gabeak2/RP2040_PIO_DAC/README.md

https://www.youtube.com/watch?v=1zT0gdcFlgw
