gabeak2/RP2040_PIO_DAC/pi_pico_dds.kicad_pcb

## KiCad design pi_pico_dds.kicad_pcb (2024-01-13)

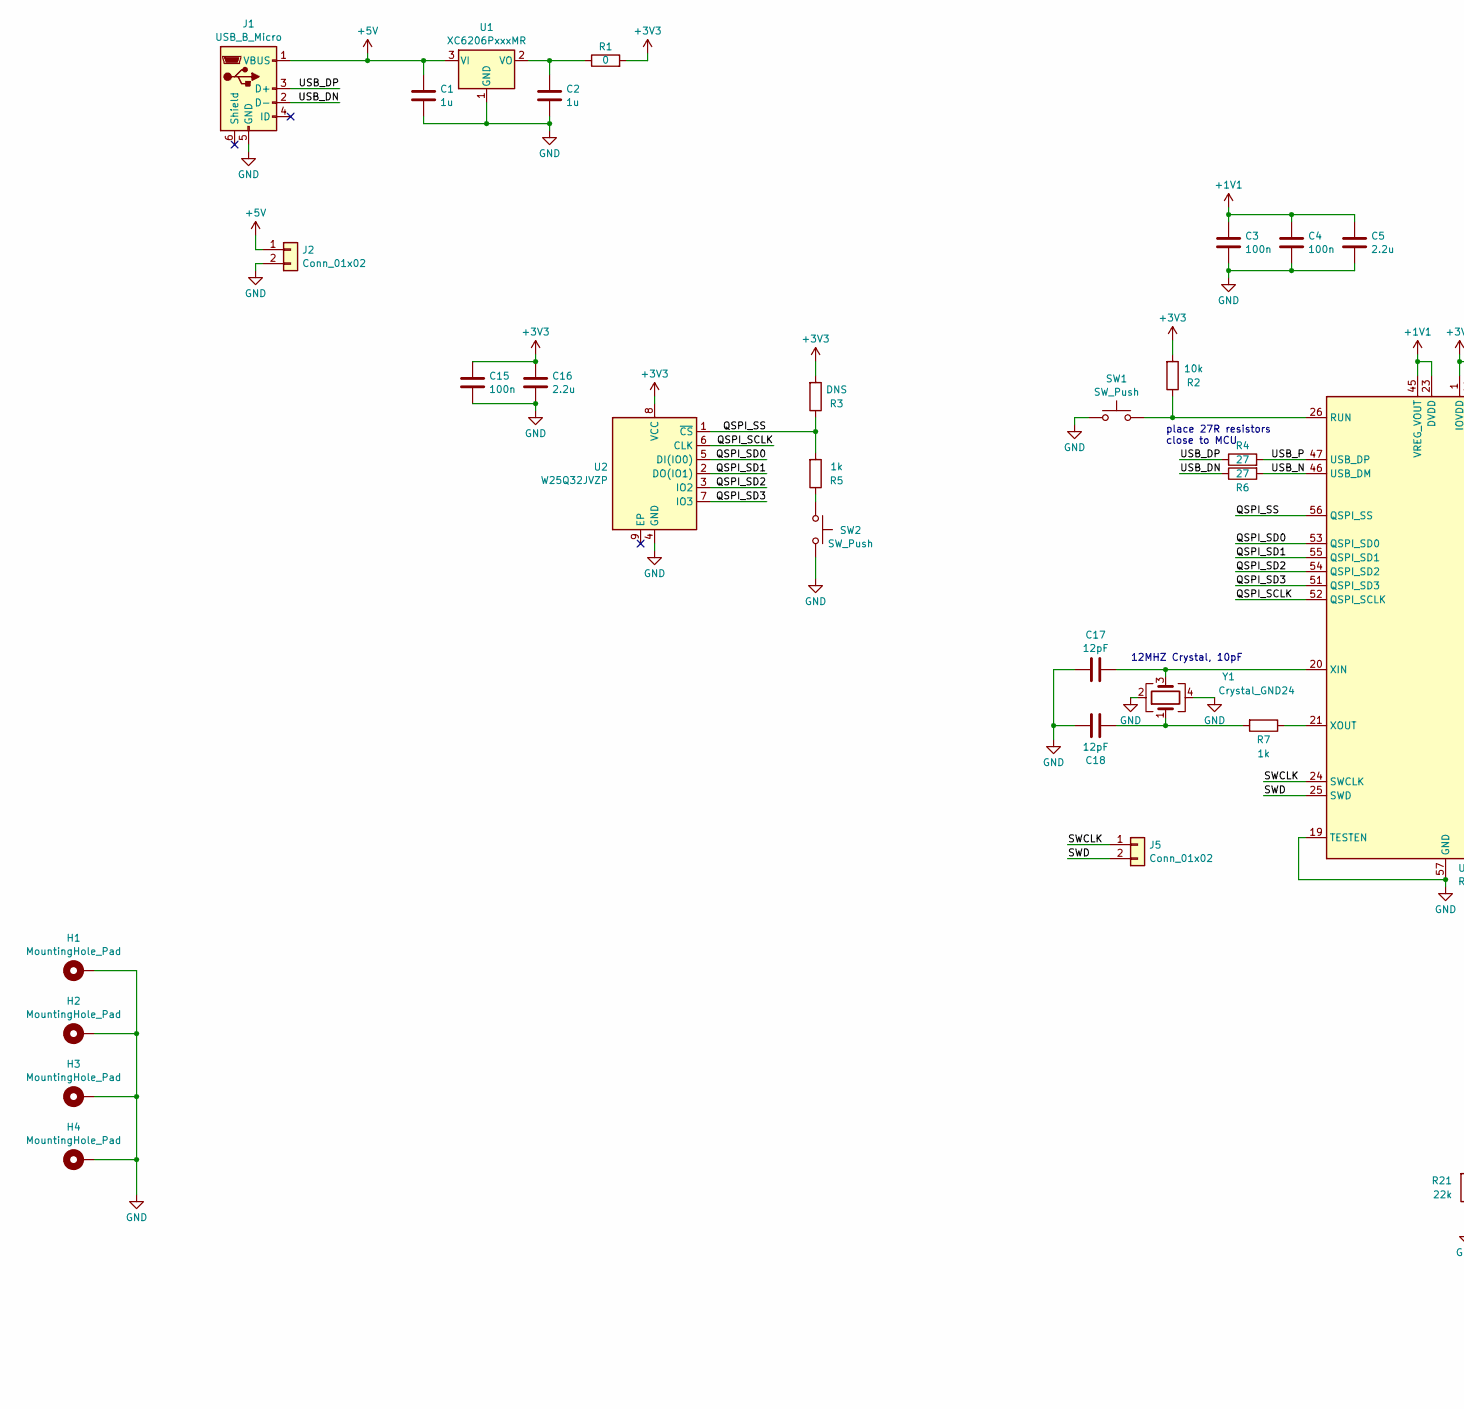
[picture p1: schematic pi_pico_dds.kicad_sch, part in row 1, column 1]

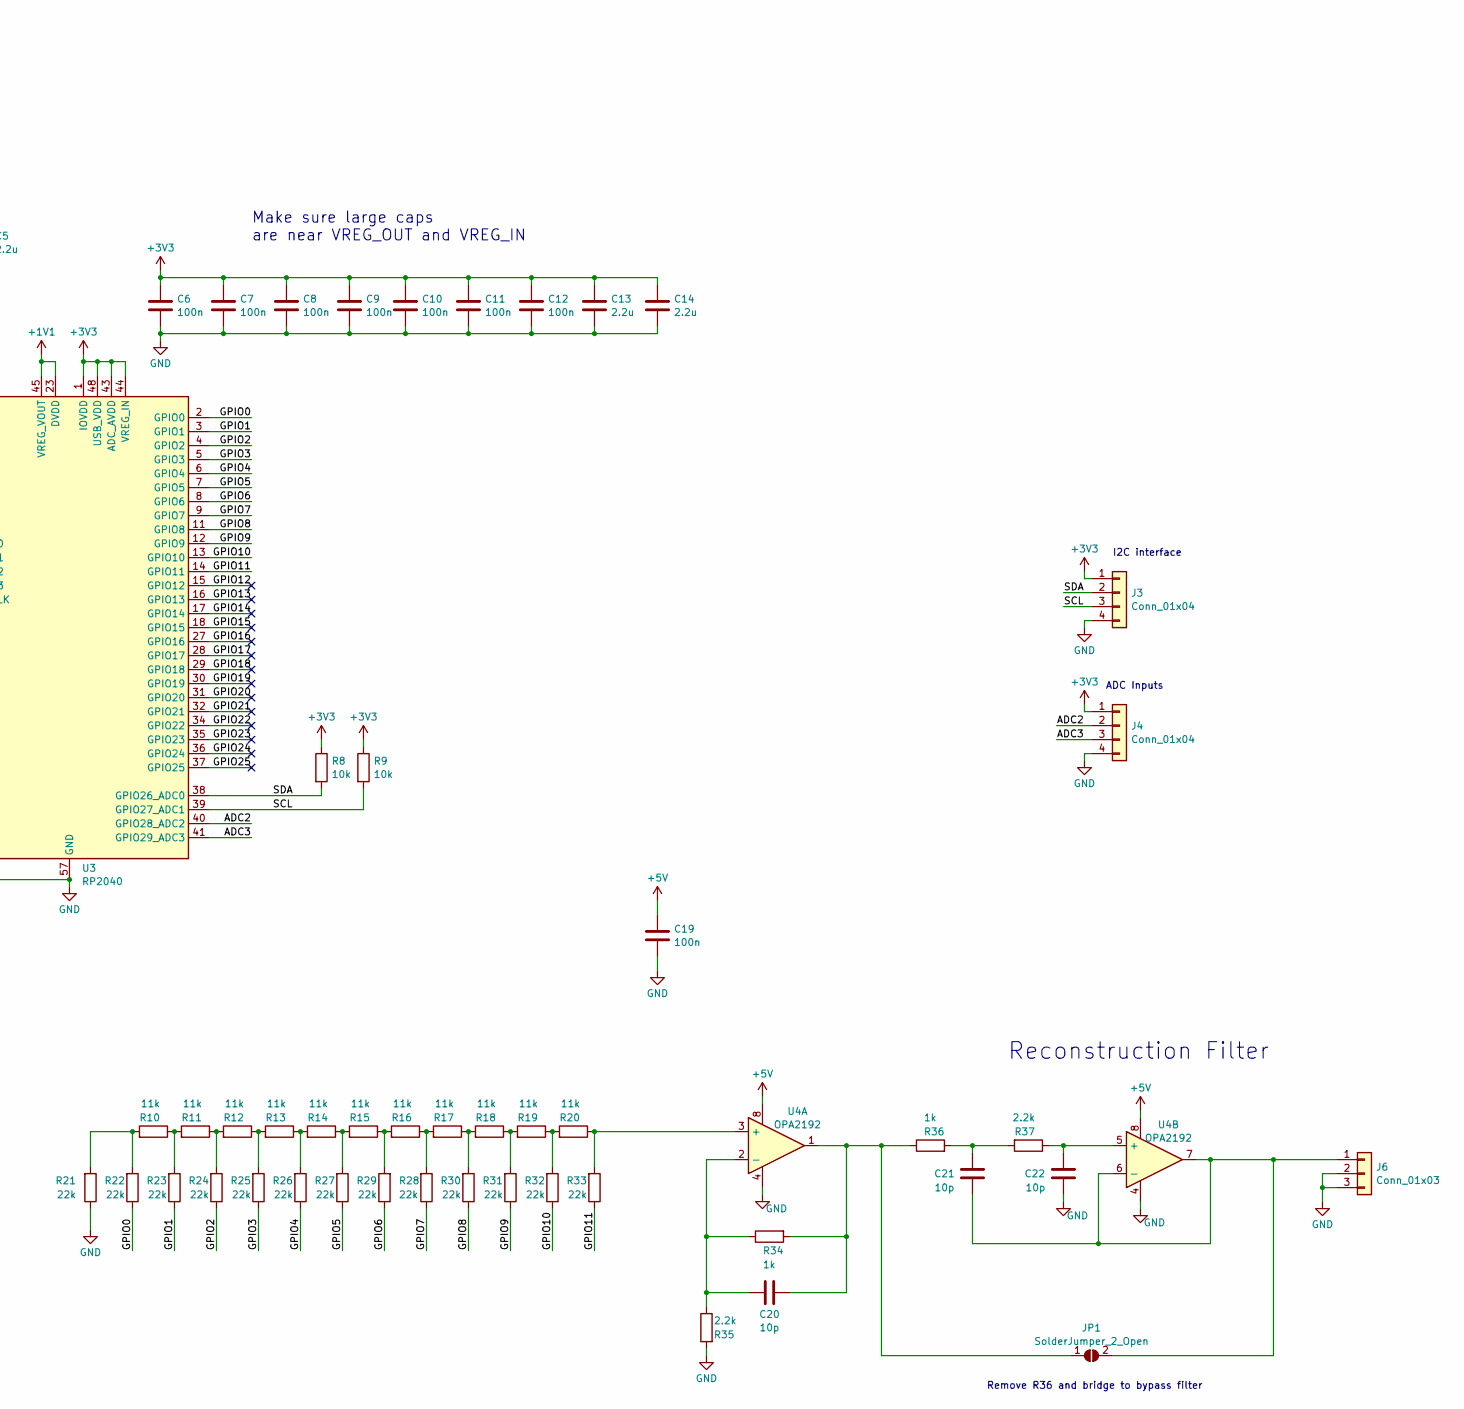
[picture p2: schematic pi_pico_dds.kicad_sch, part in row 1, column 2]

Parts:
C1, C2: 1u; C_0402_1005Metric; LCSC C52923
C3, C4, C6, C7, C8, C9, C10, C11, C12, C15, C19: 100n; C_0402_1005Metric; LCSC C307331
C5, C13, C14, C16: 2.2u; C_0402_1005Metric; LCSC C12530
C17, C18: 12pF; C_0402_1005Metric; LCSC C1547
C20, C21, C22: 10p; C_0402_1005Metric; LCSC C32949
H1, H2, H3, H4: MountingHole_Pad; MountingHole_2.2mm_M2_DIN965_Pad
J1: USB_B_Micro; USB_Micro-B_Molex-105017-0001; LCSC C505111
J2, J5: Conn_01x02; PinSocket_1x02_P2.54mm_Vertical
J3, J4: Conn_01x04; PinSocket_1x04_P2.54mm_Vertical
J6: Conn_01x03; PinSocket_1x03_P2.54mm_Vertical
JP1: SolderJumper_2_Open; SolderJumper-2_P1.3mm_Open_Pad1.0x1.5mm
R1: 0; R_0402_1005Metric; LCSC C17168
R2, R8, R9: 10k; R_0402_1005Metric; LCSC C25744
R3: DNS; R_0402_1005Metric
R4, R6: 27; R_0402_1005Metric; LCSC C25100
R5, R7, R34, R36: 1k; R_0402_1005Metric; LCSC C11702
R10, R11, R12, R13, R14, R15, R16, R17, R18, R19, R20: 11k; R_0402_1005Metric; LCSC C705064
R21, R22, R23, R24, R25, R26, R27, R28, R29, R30, R31, R32, R33: 22k; R_0402_1005Metric; LCSC C326601
R35, R37: 2.2k; R_0402_1005Metric; LCSC C25879
SW1, SW2: SW_Push; SW_Push_1P1T_XKB_TS-1187A
U1: XC6206PxxxMR; SOT-23-3; LCSC C5446
U2: W25Q32JVZP; WSON-8-1EP_6x5mm_P1.27mm_EP3.4x4.3mm; LCSC C571260
U3: RP2040; QFN-56-1EP_7x7mm_P0.4mm_EP3.2x3.2mm; LCSC C2040
U4: OPA2192; SOIC-8_3.9x4.9mm_P1.27mm; LCSC C110074
Y1: Crystal_GND24; Crystal_SMD_3225-4Pin_3.2x2.5mm; LCSC C50430

Connections:
+1V1: C3.1, C4.1, C5.1, U3.23 (DVDD), U3.45 (VREG_VOUT), U3.50 (DVDD)
+3V3: C6.1, C7.1, C8.1, C9.1, C10.1, C11.1, C12.1, C13.1, C14.1, C15.1, C16.1, J3.1, J4.1, R1.2, R2.2, R3.2, R8.1, R9.1, U2.8 (VCC), U3.1 (IOVDD), U3.10 (IOVDD), U3.22 (IOVDD), U3.33 (IOVDD), U3.42 (IOVDD), U3.43 (ADC_AVDD), U3.44 (VREG_IN), U3.48 (USB_VDD), U3.49 (IOVDD)
+5V: C1.1, C19.1, J1.1 (VBUS), J2.1, U1.3 (VI), U4.8
/ADC2: J4.2, U3.40 (GPIO28_ADC2)
/ADC3: J4.3, U3.41 (GPIO29_ADC3)
/GPIO0: R22.1, U3.2 (GPIO0)
/GPIO1: R23.1, U3.3 (GPIO1)
/GPIO2: R24.1, U3.4 (GPIO2)
/GPIO3: R25.1, U3.5 (GPIO3)
/GPIO4: R26.1, U3.6 (GPIO4)
/GPIO5: R27.1, U3.7 (GPIO5)
/GPIO6: R28.1, U3.8 (GPIO6)
/GPIO7: R29.1, U3.9 (GPIO7)
/GPIO8: R30.1, U3.11 (GPIO8)
/GPIO9: R31.1, U3.12 (GPIO9)
/GPIO10: R32.1, U3.13 (GPIO10)
/GPIO11: R33.1, U3.14 (GPIO11)
/GPIO12: U3.15 (GPIO12)
/GPIO13: U3.16 (GPIO13)
/GPIO14: U3.17 (GPIO14)
/GPIO15: U3.18 (GPIO15)
/GPIO16: U3.27 (GPIO16)
/GPIO17: U3.28 (GPIO17)
/GPIO18: U3.29 (GPIO18)
/GPIO19: U3.30 (GPIO19)
/GPIO20: U3.31 (GPIO20)
/GPIO21: U3.32 (GPIO21)
/GPIO22: U3.34 (GPIO22)
/GPIO23: U3.35 (GPIO23)
/GPIO24: U3.36 (GPIO24)
/GPIO25: U3.37 (GPIO25)
/QSPI_SCLK: U2.6 (CLK), U3.52 (QSPI_SCLK)
/QSPI_SD0: U2.5 (DI(IO0)), U3.53 (QSPI_SD0)
/QSPI_SD1: U2.2 (DO(IO1)), U3.55 (QSPI_SD1)
/QSPI_SD2: U2.3 (IO2), U3.54 (QSPI_SD2)
/QSPI_SD3: U2.7 (IO3), U3.51 (QSPI_SD3)
/QSPI_SS: R3.1, R5.2, U2.1 (~CS), U3.56 (QSPI_SS)
/SCL: J3.3, R9.2, U3.39 (GPIO27_ADC1)
/SDA: J3.2, R8.2, U3.38 (GPIO26_ADC0)
/SWCLK: J5.1, U3.24 (SWCLK)
/SWD: J5.2, U3.25 (SWD)
/USB_DN: J1.2 (D-), R6.1
/USB_DP: J1.3 (D+), R4.1
/USB_N: R6.2, U3.46 (USB_DM)
/USB_P: R4.2, U3.47 (USB_DP)
GND: C1.2, C2.2, C3.2, C4.2, C5.2, C6.2, C7.2, C8.2, C9.2, C10.2, C11.2, C12.2, C13.2, C14.2, C15.2, C16.2, C17.1, C18.1, C19.2, C22.2, H1.1, H2.1, H3.1, H4.1, J1.5 (GND), J2.2, J3.4, J4.4, J6.2, J6.3, R21.1, R35.2, SW1.1, SW2.1, U1.1 (GND), U2.4 (GND), U3.19 (TESTEN), U3.57 (GND), U4.4, Y1.2, Y1.4
unnamed: C18.2, R7.2, Y1.1
unnamed: C21.1, R36.2, R37.2
unnamed: C21.2, J6.1, JP1.2 (B), U4.6 (-), U4.7
unnamed: C20.1, JP1.1 (A), R34.2, R36.1, U4.1
unnamed: R5.1, SW2.2
unnamed: R10.1, R11.2, R23.2
unnamed: R10.2, R21.2, R22.2
unnamed: R11.1, R12.2, R24.2
unnamed: R12.1, R13.2, R25.2
unnamed: R13.1, R14.2, R26.2
unnamed: R14.1, R15.2, R27.2
unnamed: R15.1, R16.2, R28.2
unnamed: R16.1, R17.2, R29.2
unnamed: R17.1, R18.2, R30.2
unnamed: R18.1, R19.2, R31.2
unnamed: R19.1, R20.2, R32.2
unnamed: C2.1, R1.1, U1.2 (VO)
unnamed: R2.1, SW1.2, U3.26 (RUN)
unnamed: C17.2, U3.20 (XIN), Y1.3
unnamed: R7.1, U3.21 (XOUT)
unnamed: R20.1, R33.2, U4.3 (+)
unnamed: C20.2, R34.1, R35.1, U4.2 (-)
unnamed: C22.1, R37.1, U4.5 (+)

Notes on the sheet:
ADC Inputs
I2C interface
place 27R resistors close to MCU
Remove R36 and bridge to bypass filter
Reconstruction Filter
Make sure large caps are near VREG_OUT and VREG_IN
12MHZ Crystal, 10pF

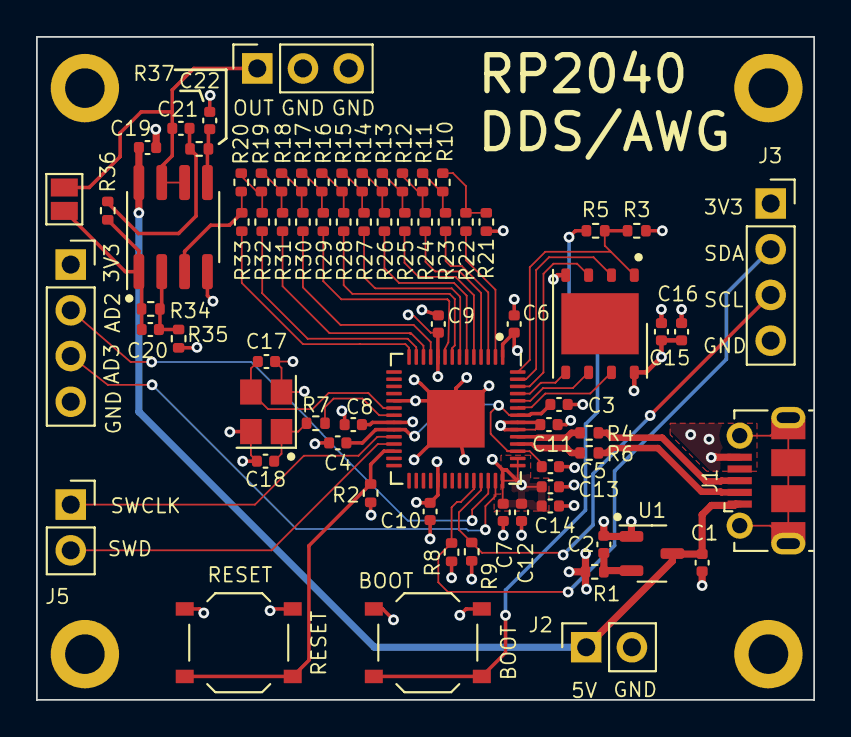
[picture p3: board pi_pico_dds.kicad_pcb from above]

Board: 4 copper layers, 43.2 x 36.8 mm, 77 parts (0 on the bottom side), 55 nets.
